Malloy-Aeronautics/T600_G071_Control_Board_V2/hw/ESC_Control_Board_STM32G071_V2.kicad_pcb

## KiCad design hw/ESC_Control_Board_STM32G071_V2.kicad_pcb (2023-08-24)

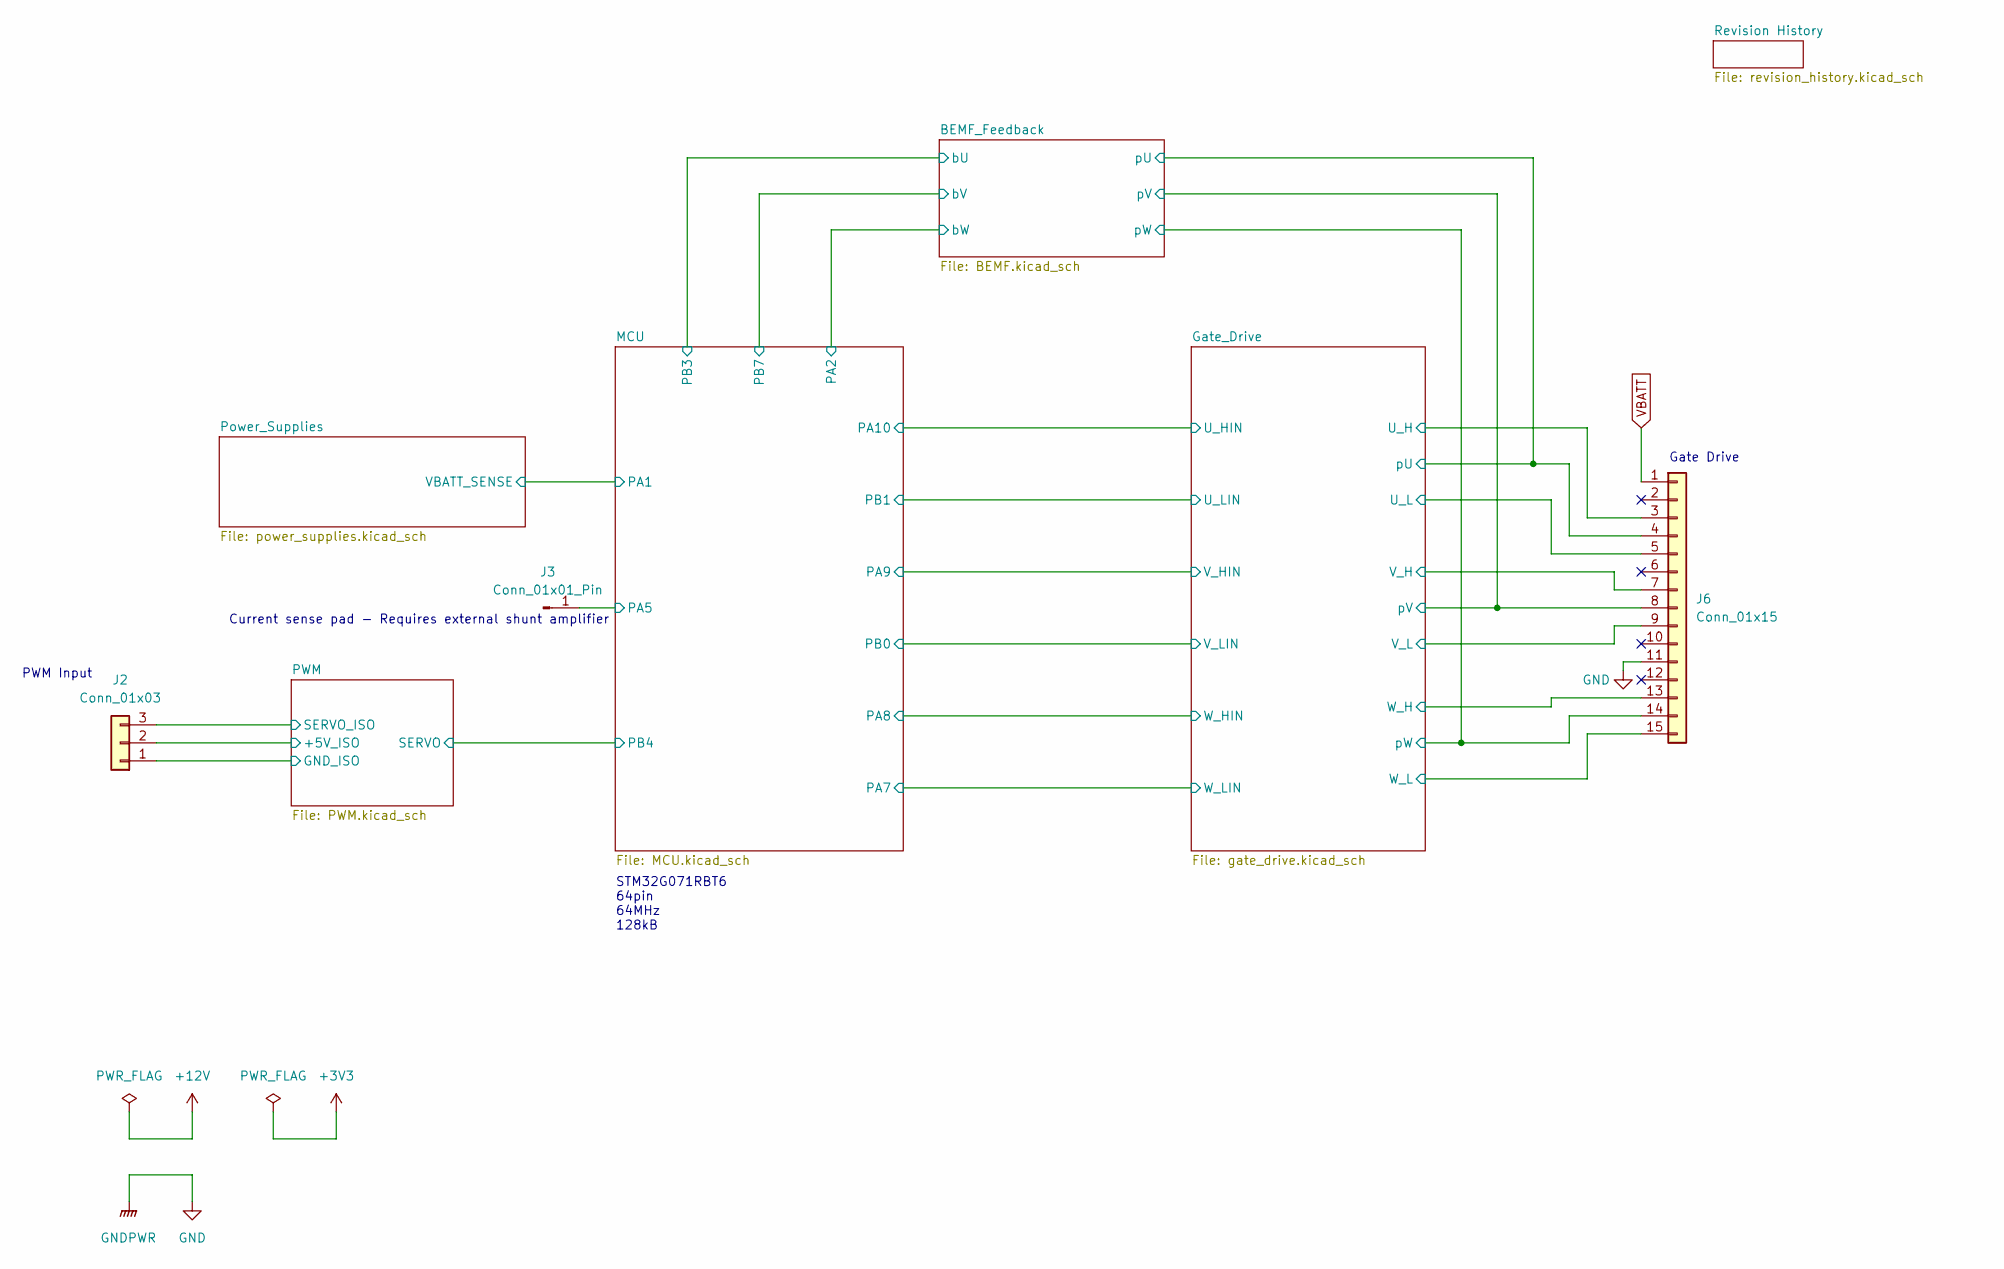
[picture p1: schematic ESC_Control_Board_STM32G071_V2.kicad_sch]

Parts:
J2: Conn_01x03; PWM_PADS
J3: Conn_01x01_Pin; TestPoint_Pad_1.0x1.0mm
J6: Conn_01x15; PinHeader_1x15_P2.00mm_Vertical

Connections:
/BEMF_Feedback/pU: J6.4; also elsewhere on the board
/BEMF_Feedback/pV: J6.8; also elsewhere on the board
/BEMF_Feedback/pW: J6.14; also elsewhere on the board
/Gate_Drive/U_H: J6.3; also elsewhere on the board
/Gate_Drive/U_L: J6.5; also elsewhere on the board
/Gate_Drive/V_H: J6.7; also elsewhere on the board
/Gate_Drive/V_L: J6.9; also elsewhere on the board
/Gate_Drive/W_H: J6.13; also elsewhere on the board
/Gate_Drive/W_L: J6.15; also elsewhere on the board
/MCU/PA5: J3.1; also elsewhere on the board
/PWM/+5V_ISO: J2.2; also elsewhere on the board
/PWM/GND_ISO: J2.1; also elsewhere on the board
/PWM/SERVO_ISO: J2.3; also elsewhere on the board
GND: J6.11; also elsewhere on the board
VBATT: J6.1; also elsewhere on the board

Notes on the sheet:
PWM Input
Gate Drive
STM32G071RBT6 64pin 64MHz 128kB
Current sense pad - Requires external shunt amplifier

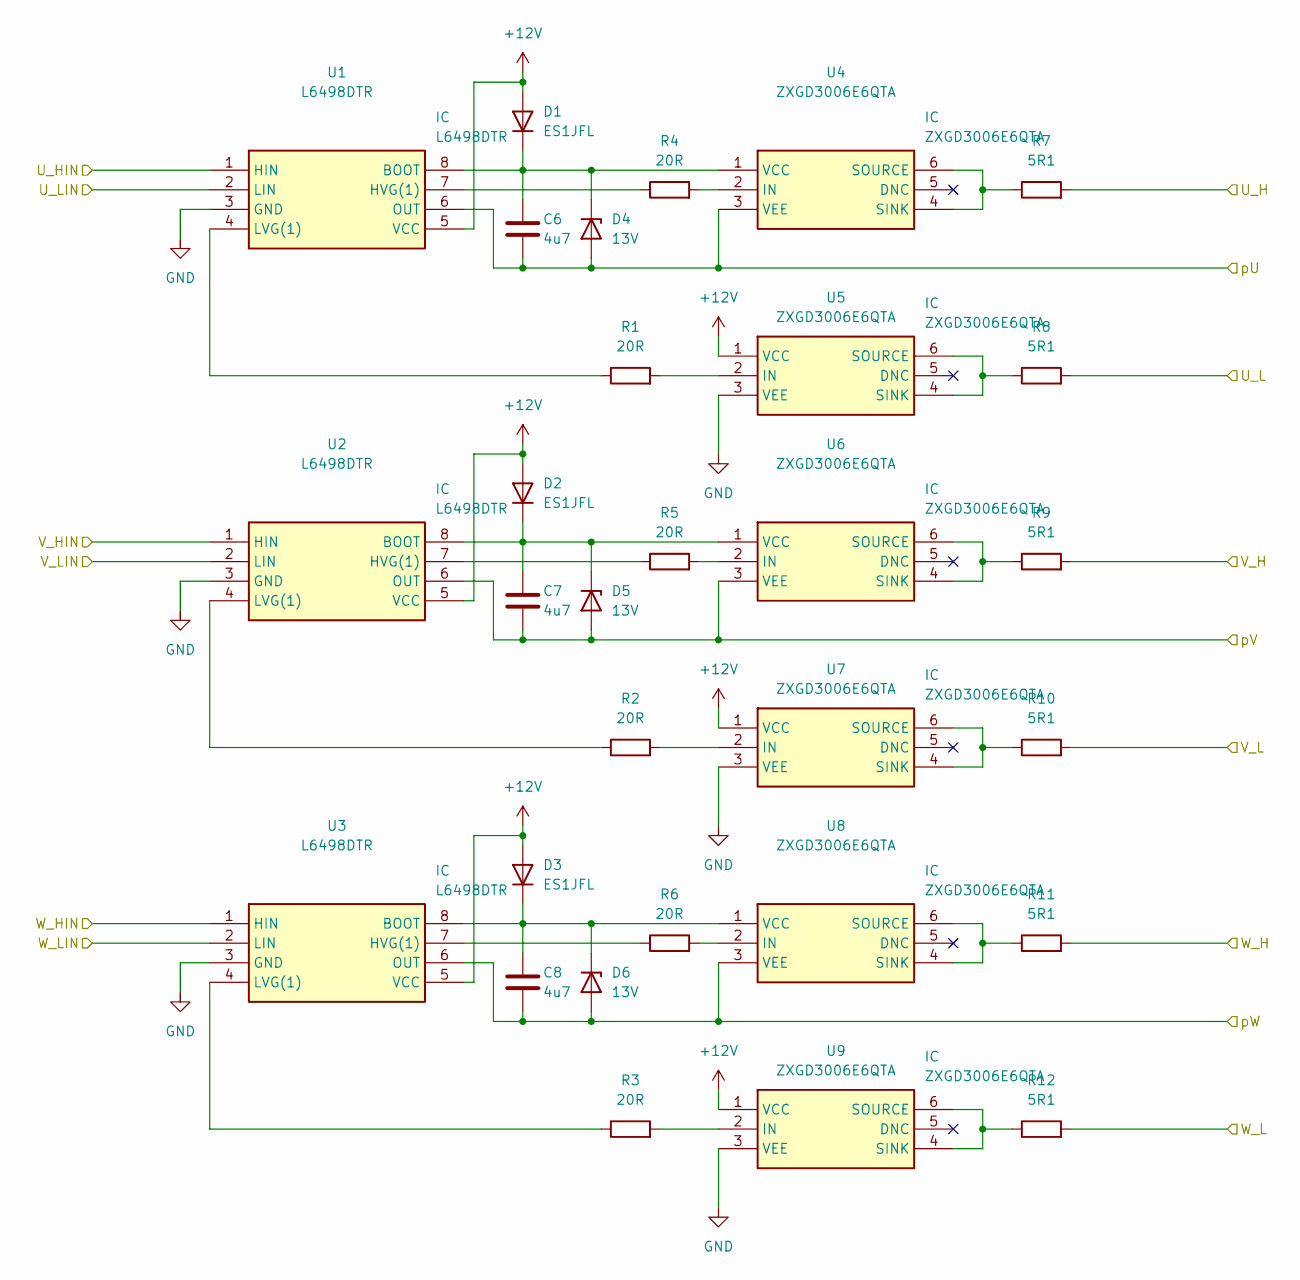
[picture p2: schematic gate_drive.kicad_sch]

Parts:
C6, C7, C8: 4u7; C_0603_1608Metric; Manufacturer_Part_Number GRT188C81E475KE13D
D1, D2, D3: ES1JFL; D_SOD-123F
D4, D5, D6: 13V; D_SOD-523
R1, R2, R3, R4, R5, R6: 20R; R_0603_1608Metric
R7, R8, R9, R10, R11, R12: 5R1; R_0805_2012Metric
U1, U2, U3: L6498DTR; SOT127P600X175-8N; Mouser Part Number 511-L6498DTR
U4, U5, U6, U7, U8, U9: ZXGD3006E6QTA; SOT95P285X140-6N; Mouser Part Number 621-ZXGD3006E6QTA

Connections:
+12V: D1.2 (A), D2.2 (A), D3.2 (A), U1.5 (VCC), U2.5 (VCC), U3.5 (VCC), U5.1 (VCC), U7.1 (VCC), U9.1 (VCC); also elsewhere on the board
/BEMF_Feedback/pU: C6.2, D4.2 (A), U1.6 (OUT), U4.3 (VEE); also elsewhere on the board
/BEMF_Feedback/pV: C7.2, D5.2 (A), U2.6 (OUT), U6.3 (VEE); also elsewhere on the board
/BEMF_Feedback/pW: C8.2, D6.2 (A), U3.6 (OUT), U8.3 (VEE); also elsewhere on the board
/Gate_Drive/U_H: R7.2; also elsewhere on the board
/Gate_Drive/U_HIN: U1.1 (HIN); also elsewhere on the board
/Gate_Drive/U_L: R8.2; also elsewhere on the board
/Gate_Drive/U_LIN: U1.2 (LIN); also elsewhere on the board
/Gate_Drive/V_H: R9.2; also elsewhere on the board
/Gate_Drive/V_HIN: U2.1 (HIN); also elsewhere on the board
/Gate_Drive/V_L: R10.2; also elsewhere on the board
/Gate_Drive/V_LIN: U2.2 (LIN); also elsewhere on the board
/Gate_Drive/W_H: R11.2; also elsewhere on the board
/Gate_Drive/W_HIN: U3.1 (HIN); also elsewhere on the board
/Gate_Drive/W_L: R12.2; also elsewhere on the board
/Gate_Drive/W_LIN: U3.2 (LIN); also elsewhere on the board
GND: U1.3 (GND), U2.3 (GND), U3.3 (GND), U5.3 (VEE), U7.3 (VEE), U9.3 (VEE); also elsewhere on the board
unnamed: C6.1, D1.1 (K), D4.1 (K), U1.8 (BOOT), U4.1 (VCC)
unnamed: C7.1, D2.1 (K), D5.1 (K), U2.8 (BOOT), U6.1 (VCC)
unnamed: C8.1, D3.1 (K), D6.1 (K), U3.8 (BOOT), U8.1 (VCC)
unnamed: R4.1, U1.7 (HVG(1))
unnamed: R1.1, U1.4 (LVG(1))
unnamed: R5.1, U2.7 (HVG(1))
unnamed: R2.1, U2.4 (LVG(1))
unnamed: R6.1, U3.7 (HVG(1))
unnamed: R3.1, U3.4 (LVG(1))
unnamed: R4.2, U4.2 (IN)
unnamed: R7.1, U4.4 (SINK), U4.6 (SOURCE)
unnamed: R1.2, U5.2 (IN)
unnamed: R8.1, U5.4 (SINK), U5.6 (SOURCE)
unnamed: R5.2, U6.2 (IN)
unnamed: R9.1, U6.4 (SINK), U6.6 (SOURCE)
unnamed: R2.2, U7.2 (IN)
unnamed: R10.1, U7.4 (SINK), U7.6 (SOURCE)
unnamed: R6.2, U8.2 (IN)
unnamed: R11.1, U8.4 (SINK), U8.6 (SOURCE)
unnamed: R3.2, U9.2 (IN)
unnamed: R12.1, U9.4 (SINK), U9.6 (SOURCE)

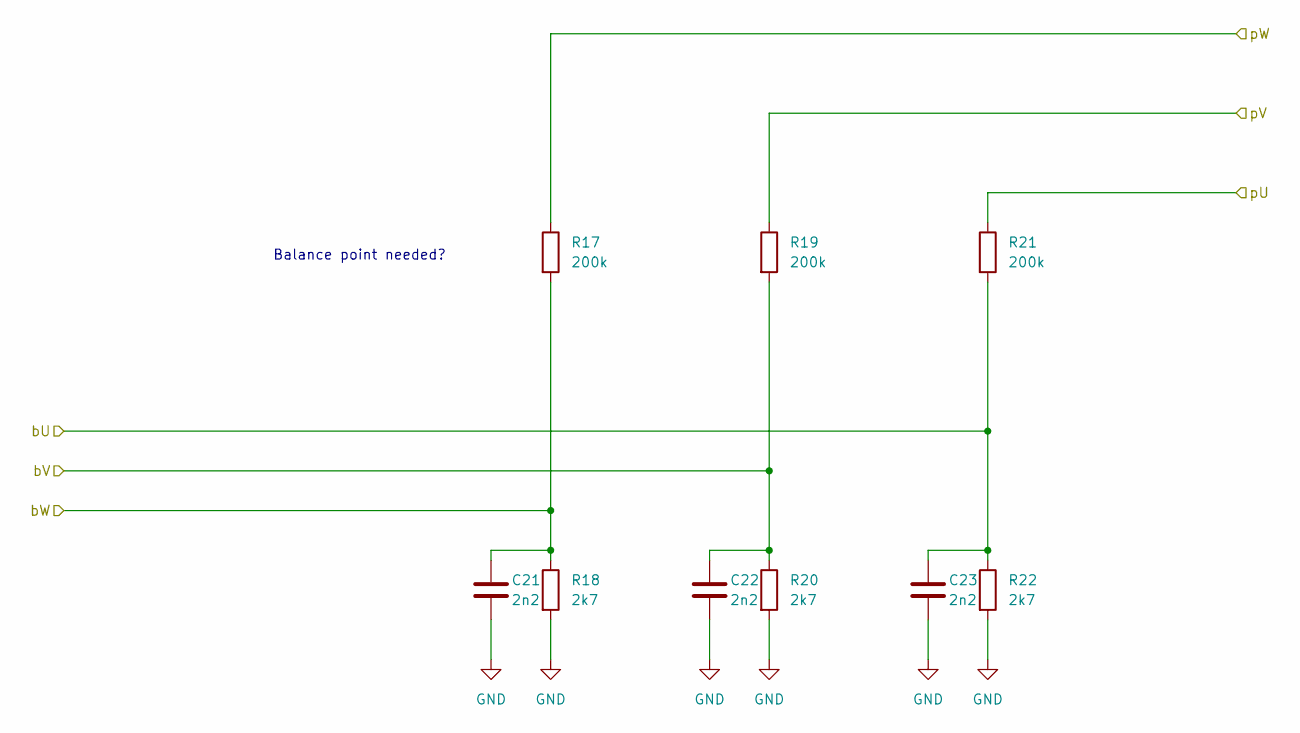
[picture p3: schematic BEMF.kicad_sch]

Parts:
C21, C22, C23: 2n2; C_0603_1608Metric
R17, R19, R21: 200k; R_0805_2012Metric
R18, R20, R22: 2k7; R_0603_1608Metric

Connections:
/BEMF_Feedback/bU: C23.1, R21.2, R22.1; also elsewhere on the board
/BEMF_Feedback/bV: C22.1, R19.2, R20.1; also elsewhere on the board
/BEMF_Feedback/bW: C21.1, R17.2, R18.1; also elsewhere on the board
/BEMF_Feedback/pU: R21.1; also elsewhere on the board
/BEMF_Feedback/pV: R19.1; also elsewhere on the board
/BEMF_Feedback/pW: R17.1; also elsewhere on the board
GND: C21.2, C22.2, C23.2, R18.2, R20.2, R22.2; also elsewhere on the board

Notes on the sheet:
Balance point needed?

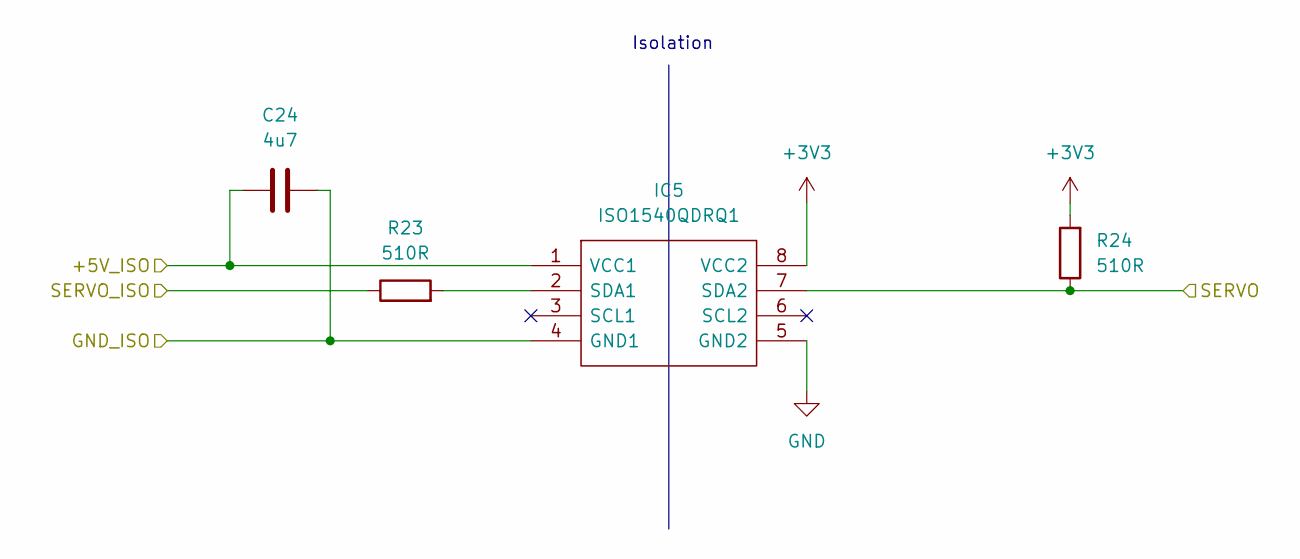
[picture p4: schematic PWM.kicad_sch]

Parts:
C24: 4u7; C_0603_1608Metric; Manufacturer_Part_Number GRT188C81E475KE13D
IC5: ISO1540QDRQ1; SOIC127P600X175-8N; Mouser Part Number 595-ISO1540QDRQ1
R23, R24: 510R; R_0603_1608Metric

Connections:
+3V3: IC5.8 (VCC2), R24.2; also elsewhere on the board
/MCU/PB4: IC5.7 (SDA2), R24.1; also elsewhere on the board
/PWM/+5V_ISO: C24.1, IC5.1 (VCC1); also elsewhere on the board
/PWM/GND_ISO: C24.2, IC5.4 (GND1); also elsewhere on the board
/PWM/SERVO_ISO: R23.1; also elsewhere on the board
GND: IC5.5 (GND2); also elsewhere on the board
unnamed: IC5.2 (SDA1), R23.2

Notes on the sheet:
Isolation

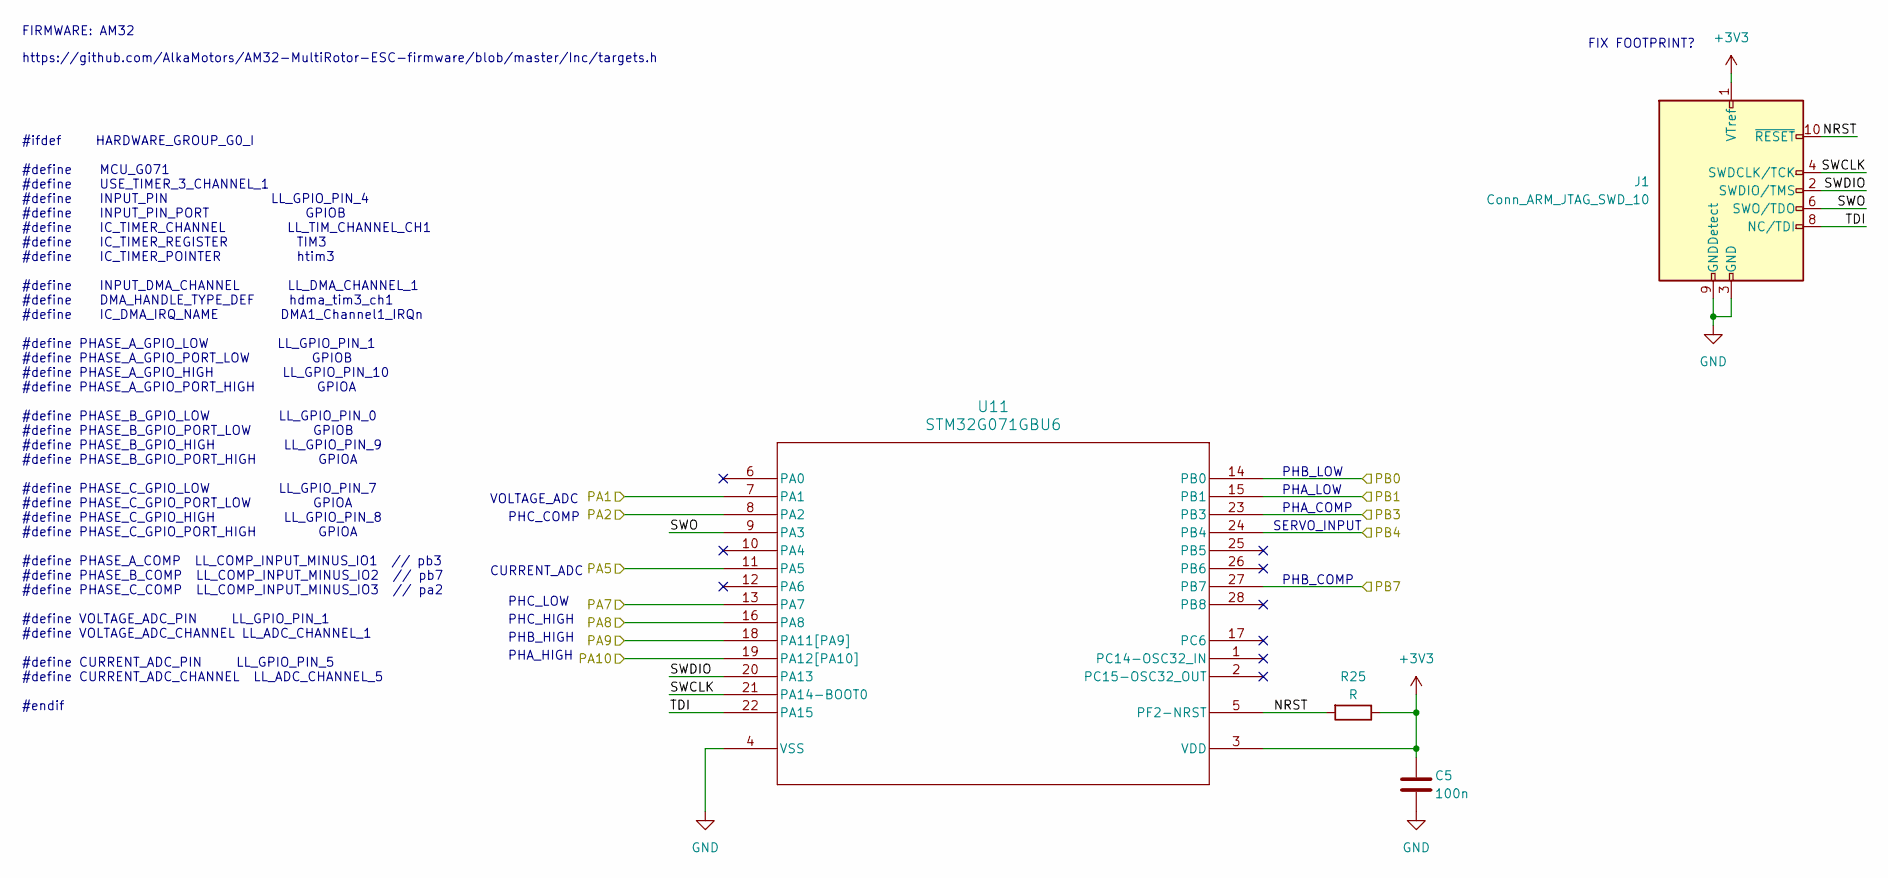
[picture p5: schematic MCU.kicad_sch]

Parts:
C5: 100n; C_0603_1608Metric
J1: Conn_ARM_JTAG_SWD_10; Tag-Connect_TC2050-IDC-NL_2x05_P1.27mm_Vertical_with_bottom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
R25: R
U11: STM32G071GBU6; UFQFPN-28

Connections:
+3V3: C5.1, J1.1 (VTref), R25.1, U11.3 (VDD); also elsewhere on the board
/BEMF_Feedback/bU: U11.23 (PB3); also elsewhere on the board
/BEMF_Feedback/bV: U11.27 (PB7); also elsewhere on the board
/BEMF_Feedback/bW: U11.8 (PA2); also elsewhere on the board
/Gate_Drive/U_HIN: U11.19 (PA12[PA10]); also elsewhere on the board
/Gate_Drive/U_LIN: U11.15 (PB1); also elsewhere on the board
/Gate_Drive/V_HIN: U11.18 (PA11[PA9]); also elsewhere on the board
/Gate_Drive/V_LIN: U11.14 (PB0); also elsewhere on the board
/Gate_Drive/W_HIN: U11.16 (PA8); also elsewhere on the board
/Gate_Drive/W_LIN: U11.13 (PA7); also elsewhere on the board
/MCU/NRST: J1.10 (~RESET), R25.2, U11.5 (PF2-NRST)
/MCU/PA1: U11.7 (PA1); also elsewhere on the board
/MCU/PA5: U11.11 (PA5); also elsewhere on the board
/MCU/PB4: U11.24 (PB4); also elsewhere on the board
/MCU/SWCLK: J1.4 (SWDCLK/TCK), U11.21 (PA14-BOOT0)
/MCU/SWDIO: J1.2 (SWDIO/TMS), U11.20 (PA13)
/MCU/SWO: J1.6 (SWO/TDO), U11.9 (PA3)
/MCU/TDI: J1.8 (NC/TDI), U11.22 (PA15)
GND: C5.2, J1.3 (GND), J1.5 (GND), J1.9 (GNDDetect), U11.4 (VSS); also elsewhere on the board

Notes on the sheet:
PHB_COMP
https://github.com/AlkaMotors/AM32-MultiRotor-ESC-firmware/blob/master/Inc/targets.h
CURRENT_ADC
FIRMWARE: AM32
PHC_HIGH
SERVO_INPUT
PHB_LOW
PHA_LOW
FIX FOOTPRINT?
PHC_COMP
PHA_COMP
PHC_LOW
PHB_HIGH
VOLTAGE_ADC
PHA_HIGH
#ifdef HARDWARE_GROUP_G0_I #define MCU_G071 #define USE_TIMER_3_CHANNEL_1 #define INPUT_PIN LL_GPIO_PIN_4 #define INPUT_PIN_PORT GPIOB #define IC_TIMER_CHANNEL LL_TIM_CHANNEL_CH1 #define IC_TIMER_REGISTER TIM3 #define IC_TIMER_POINTER htim3 #define INPUT_DMA_CHANNEL LL_DMA_CHANNEL_1 #define DMA_HAN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

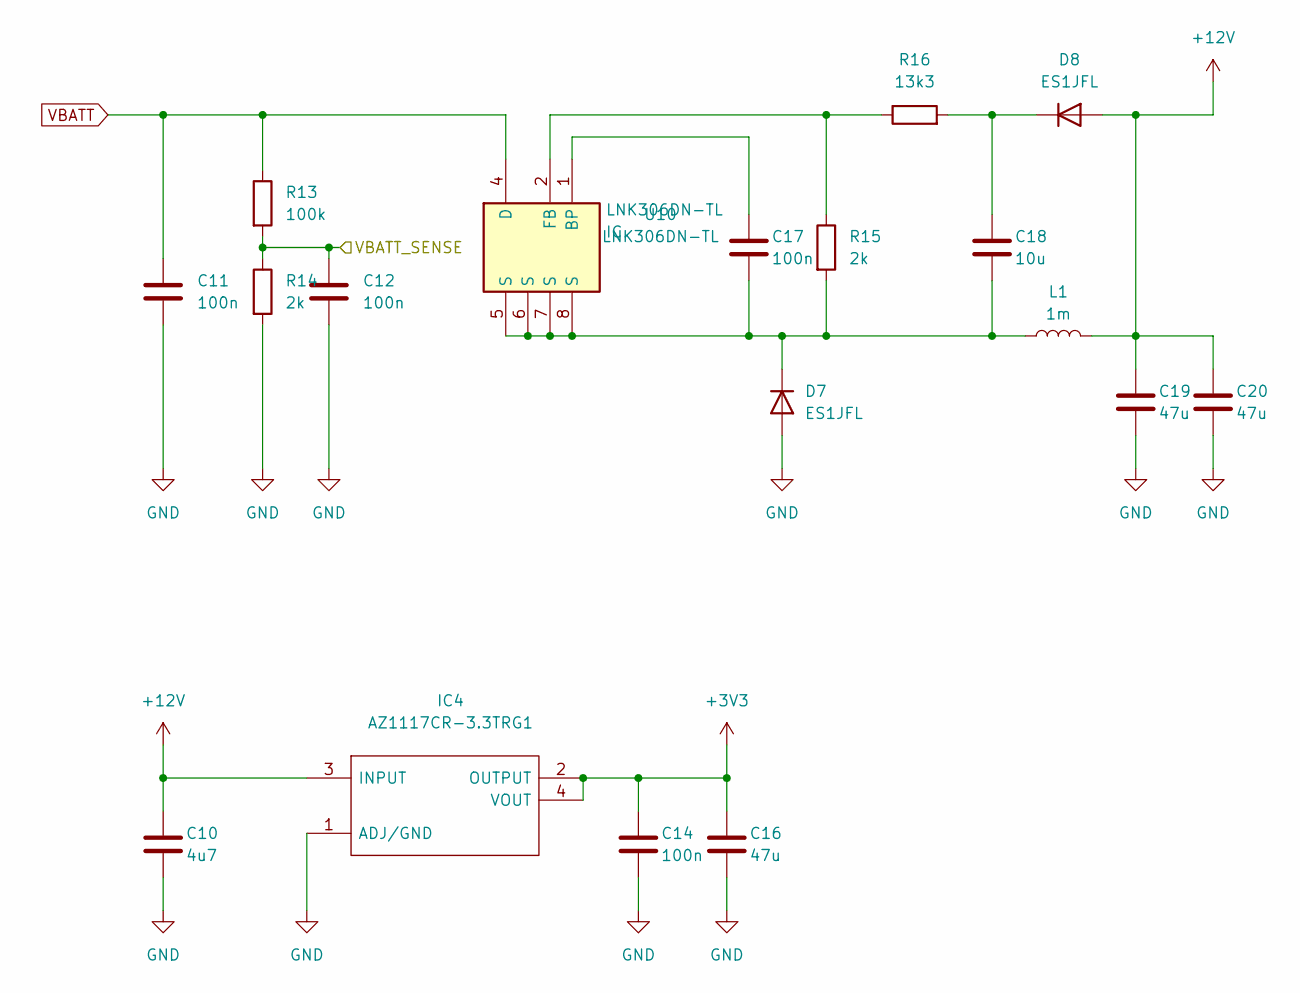
[picture p6: schematic power_supplies.kicad_sch]

Parts:
C10: 4u7; C_0603_1608Metric; Manufacturer_Part_Number GRT188C81E475KE13D
C11: 100n; C_0805_2012Metric
C12, C14, C17: 100n; C_0603_1608Metric
C16, C19, C20: 47u; C_1210_3225Metric
C18: 10u; C_0603_1608Metric
D7, D8: ES1JFL; D_SOD-123F
IC4: AZ1117CR-3.3TRG1; AZ1117CR33TRG1; Mouser Part Number 621-AZ1117CR-3.3TRG1
L1: 1m; L_7.3x7.3_H4.5
R13: 100k; R_0805_2012Metric
R14, R15: 2k; R_0603_1608Metric
R16: 13k3; R_0603_1608Metric
U10: LNK306DN-TL; SOIC127P600X175-8N_MISSING_PIN; Mouser Part Number 869-LNK306DN-TL

Connections:
+3V3: C14.1, C16.1, IC4.2 (OUTPUT), IC4.4 (VOUT); also elsewhere on the board
+12V: C10.1, C19.1, C20.1, D8.2 (A), IC4.3 (INPUT), L1.2; also elsewhere on the board
/MCU/PA1: C12.1, R13.2, R14.1; also elsewhere on the board
GND: C10.2, C11.2, C12.2, C14.2, C16.2, C19.2, C20.2, D7.2 (A), IC4.1 (ADJ/GND), R14.2; also elsewhere on the board
unnamed: C17.2, C18.2, D7.1 (K), L1.1, R15.2, U10.5 (S), U10.6 (S), U10.7 (S), U10.8 (S)
unnamed: C18.1, D8.1 (K), R16.2
unnamed: C17.1, U10.1 (BP)
unnamed: R15.1, R16.1, U10.2 (FB)
VBATT: C11.1, R13.1, U10.4 (D); also elsewhere on the board

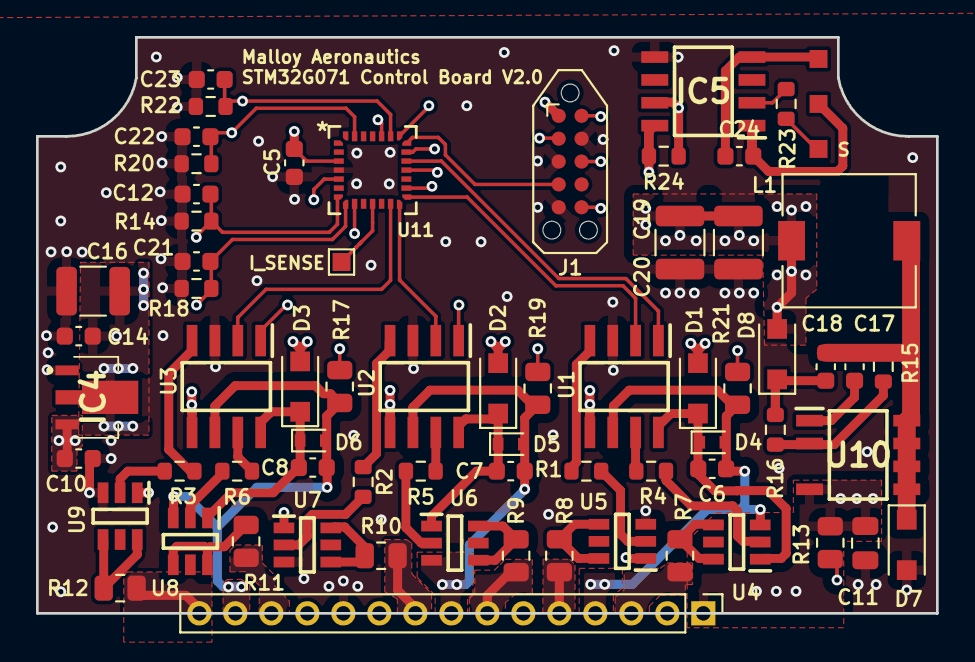
[picture p7: board ESC_Control_Board_STM32G071_V2.kicad_pcb from above]

Board: 6 copper layers, 50.0 x 32.0 mm, 67 parts (0 on the bottom side), 59 nets.
