Malloy-Aeronautics/T600_G071_Control_Board_V2/(commit log)

2023-05-23 Updated submodule version for kicad library
2023-06-05 Layout updates
    [CAN.kicad_sch, ESC_Control_Board_STM32G071.kicad_pcb, ESC_Control_Board_STM32G071.kicad_sch, MCU.kicad_sch, PWM.kicad_sch, current_sense.kicad_sch, power_supplies.kicad_sch, untitled.kicad_sch]
2023-06-05 Renamed gate-drive sheet
    [gate_drive.kicad_sch]
2023-06-09 Updates for review
    [CAN.kicad_sch, ESC_Control_Board_STM32G071.kicad_pcb, ESC_Control_Board_STM32G071.kicad_sch, MCU.kicad_sch, revision_history.kicad_sch]
2023-06-09 added hw folder
    [BEMF.kicad_sch, CAN.kicad_sch, ESC_Control_Board_STM32G071.kicad_pcb, ESC_Control_Board_STM32G071.kicad_sch, MCU.kicad_sch, PWM.kicad_sch, current_sense.kicad_sch, gate_drive.kicad_sch]
2023-06-09 connected interrupt pins to CAN controller
    [CAN.kicad_sch, ESC_Control_Board_STM32G071.kicad_pcb, ESC_Control_Board_STM32G071.kicad_sch, MCU.kicad_sch, power_supplies.kicad_sch]
2023-06-20 Revision V1.0
    [ESC_Control_Board_STM32G071.kicad_pcb, MCU.kicad_sch, current_sense.kicad_sch]
2023-06-20 Added gerbers
2023-08-16 update comments
    [CAN.kicad_sch, ESC_Control_Board_STM32G071.kicad_pcb, MCU.kicad_sch, PWM.kicad_sch, current_sense.kicad_sch, gate_drive.kicad_sch, power_supplies.kicad_sch]
2023-08-17 added ma_kicad_library as submodule
    [ESC_Control_Board_STM32G071_V2.kicad_pcb, ESC_Control_Board_STM32G071_V2.kicad_sch]
